leehambley/StrutIsolator_FEM/freecad/StrutIsolator.FCStd

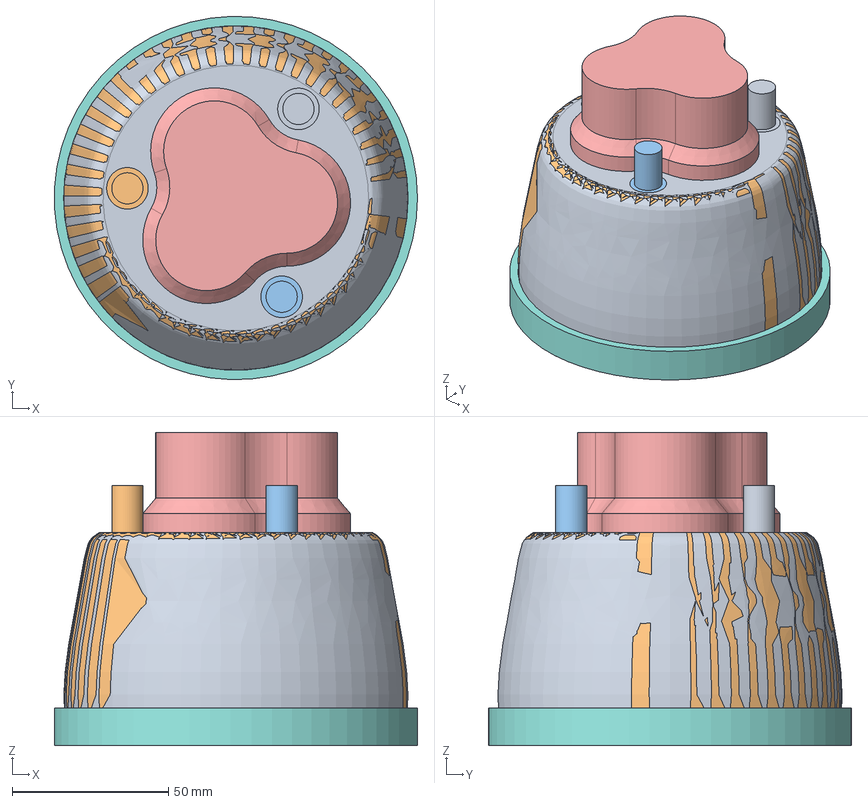
[picture p4: CAD file, 2026-11-12]
freecad/StrutIsolator.FCStd
116.2 x 116.3 x 100.3 mm
TopPlate x 2
CupSide x 2
CupSurface x 2
OuterSolid x 2
HousingPlate x 2
HousingSide x 2
HousingSurface x 2
HousingSolid x 2
Stud1 x 2
Stud2 x 2
Stud3 x 2
Rubber x 2
CastingCore x 2
InnerDisc x 2
PegCollar x 2
PourDam x 2
Body_OuterShell
Body_HousingTop
