leehambley/StrutIsolator_FEM/manufacturing/casting_core_print.stl

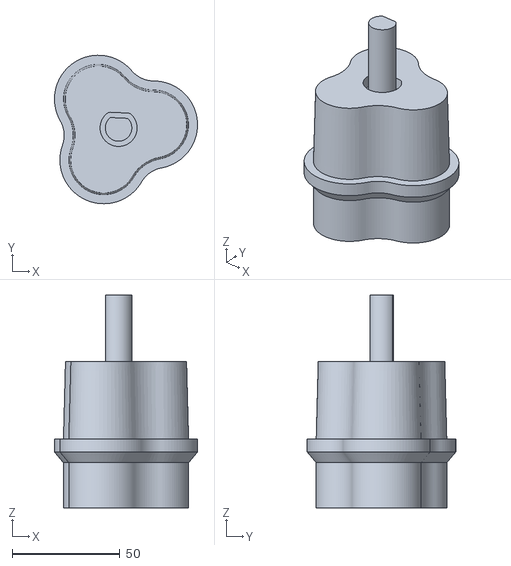
[picture p5: CAD file, 2026-11-12]
manufacturing/casting_core_print.stl
66.5 x 69.0 x 99.0
