leehambley/StrutIsolator_FEM/step/pour_dam.step

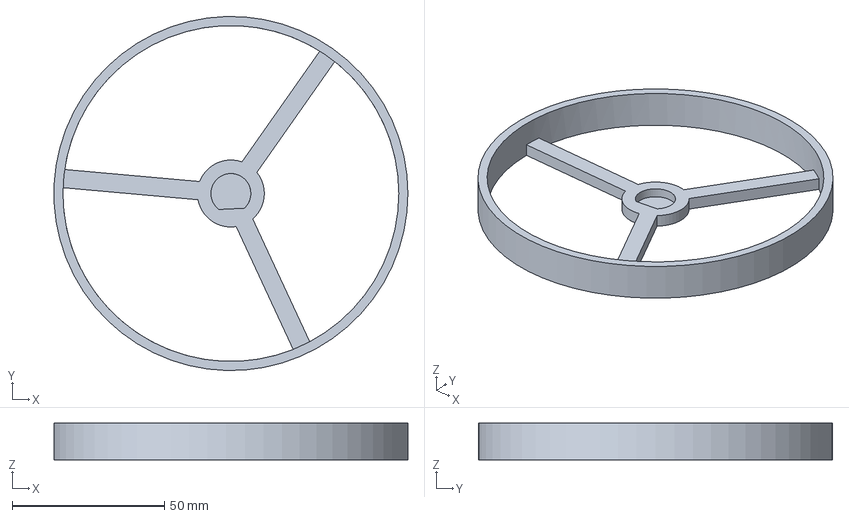
[picture p6: CAD file, 2026-11-12]
step/pour_dam.step
116.2 x 116.3 x 12.0 mm
