leehambley/StrutIsolator_FEM/manufacturing/inner_disc_print.stl

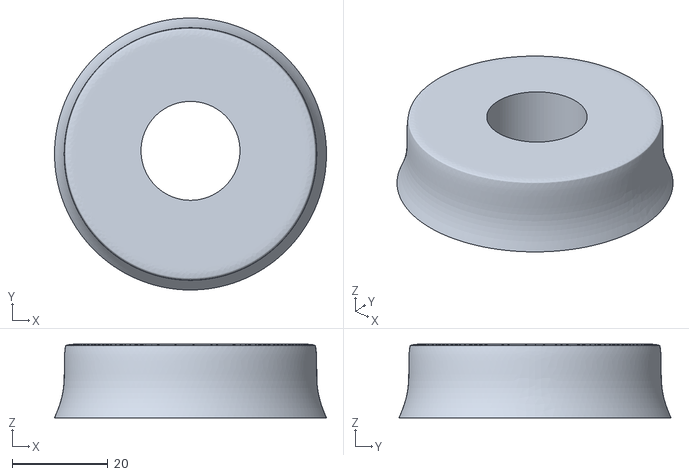
[picture p7: CAD file, 2026-11-12]
manufacturing/inner_disc_print.stl
56.9 x 56.9 x 15.4
