leehambley/StrutIsolator_FEM/step/peg_collar.step

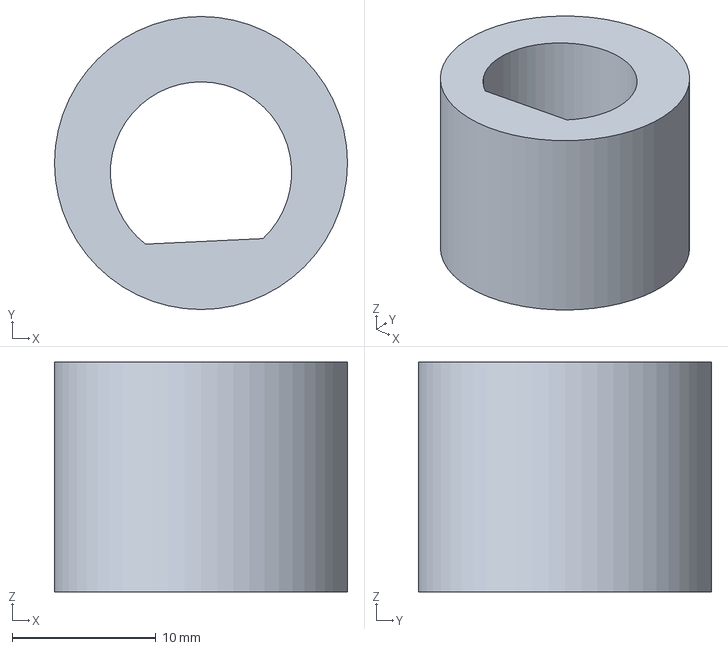
[picture p8: CAD file, 2026-11-12]
step/peg_collar.step
20.4 x 20.4 x 16.0 mm
