leehambley/StrutIsolator_FEM/step/casting_core.step

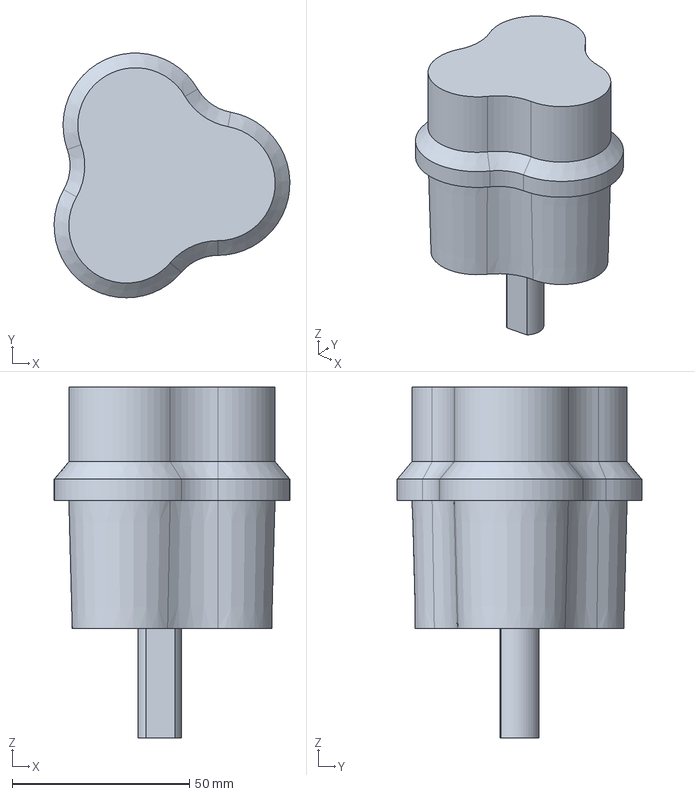
[picture p9: CAD file, 2026-11-09]
step/casting_core.step
66.5 x 69.0 x 99.0 mm
