leehambley/StrutIsolator_FEM/step/rubber_original.step

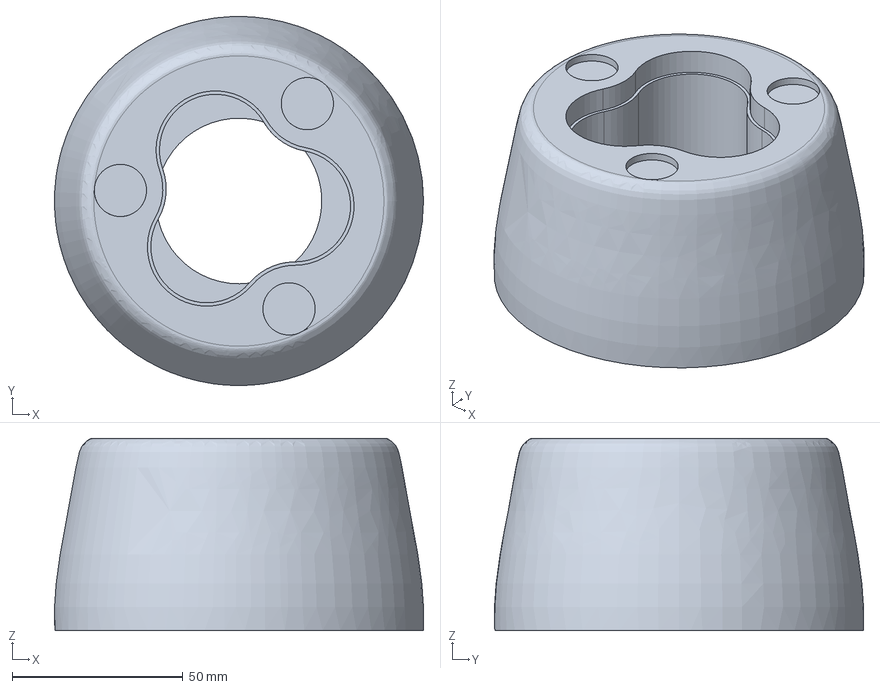
[picture p10: CAD file, 2026-11-09]
step/rubber_original.step
108.1 x 108.1 x 56.3 mm
