leehambley/StrutIsolator_FEM/step/housing_top.step

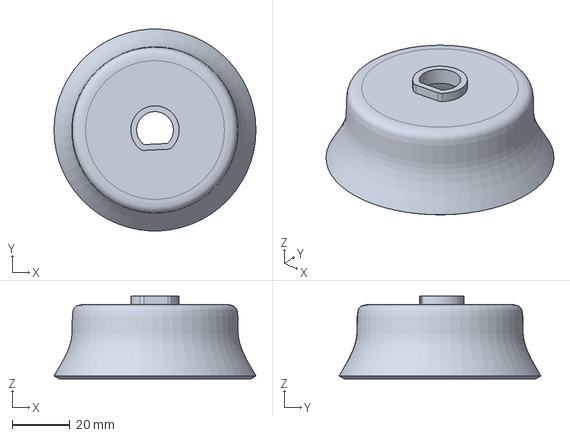
[picture p11: CAD file, 2026-10-30]
step/housing_top.step
69.8 x 69.7 x 28.6 mm
