leehambley/StrutIsolator_FEM/step/outer_shell.step

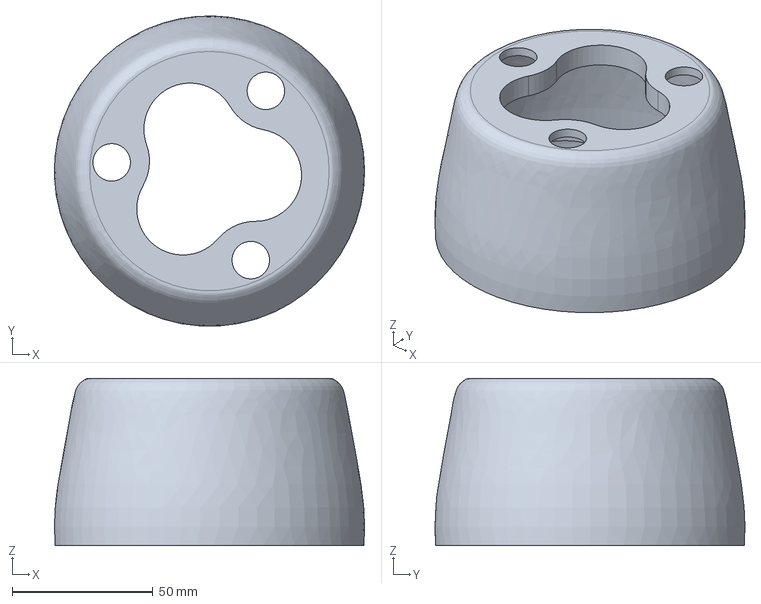
[picture p12: CAD file, 2026-10-30]
step/outer_shell.step
110.2 x 110.1 x 59.3 mm
