leehambley/StrutIsolator_FEM/(list of files, cad)

Other CAD files:
manufacturing/peg_collar_print.stl
step/inner_disc.step
manufacturing/pour_dam_print.stl
print/casting_core.stl
print/inner_disc.stl
print/peg_collar.stl
print/pour_dam.stl
