leehambley/StrutIsolator_FEM/images/section_changes_preview.png

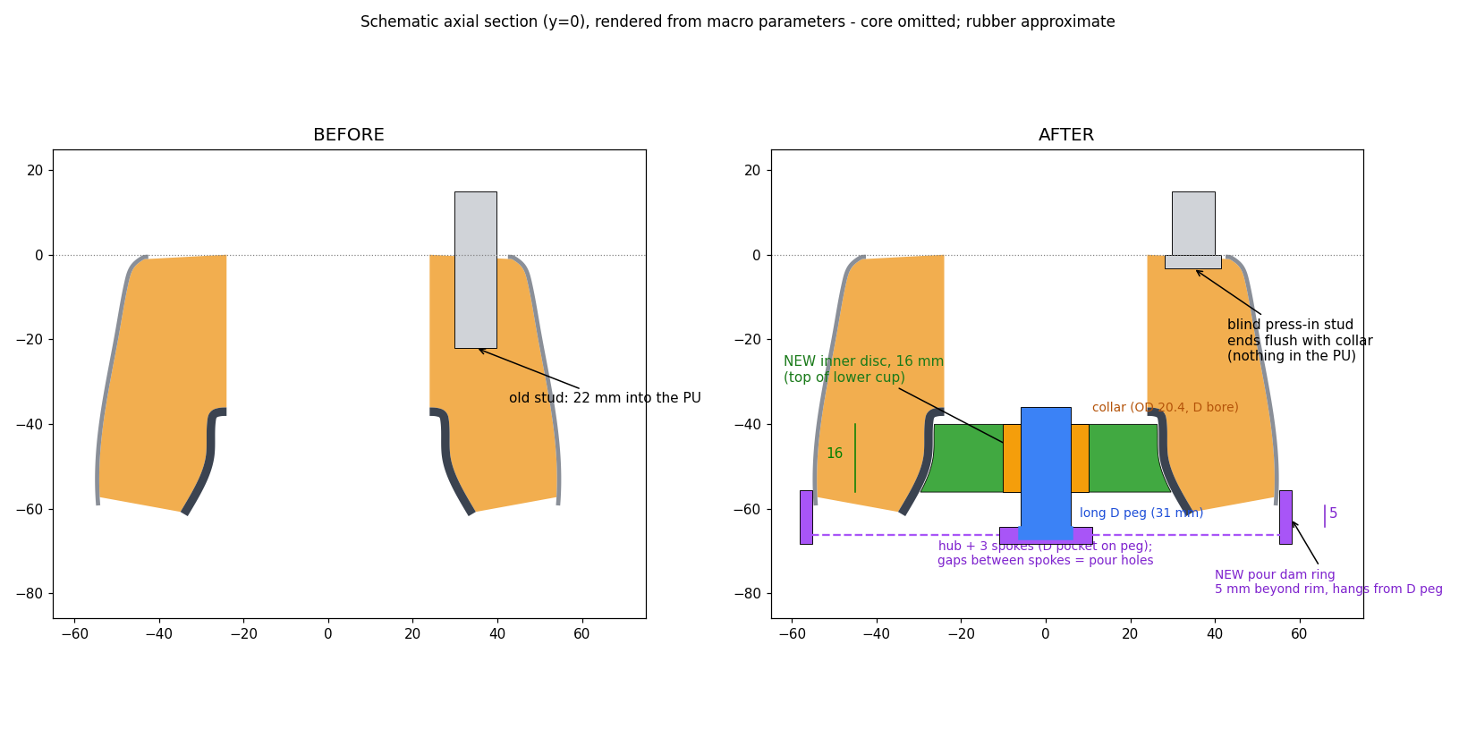
images/section_changes_preview.png
