leehambley/StrutIsolator_FEM/(commit log)

2026-10-30 Add 280Z strut isolator model, casting core, FEM results and macros
    FreeCAD model reverse-engineered from the two scans, STEP/STL exports,
    CalculiX results and animations, and the parametric build macro.
    Claude-Session: https://claude.ai/code/session_014DwErt9jvwaVCvioPG7UC8
    [StrutIsolator.FCStd, casting_core.step, casting_core.stl, casting_core_print_orientation.stl, housing_top.step, outer_shell.step, rubber_original.step]
2026-11-09 Blind press-in studs, 12 mm inner disc, peg collar and longer D peg
    Studs now end flush with the bolt-hole collar instead of embedding 22 mm.
    Add parametric InnerDisc (DISC_H) and PegCollar (20 mm hole) parts; D peg
    length follows the disc height. Add schematic section preview.
2026-11-09 Pour dam with D-peg hub, inner disc, peg collar; rebuilt outputs
    Macro verified in FreeCAD 1.1 (all solids valid, no part overlaps, positive
    clearances). PourDam is a ring over the shell rim with a spoked hub that
    seats on the now ~31 mm D peg; spoke gaps are the pour holes. Regenerated
    STEP/STL/FCStd. casting_core_print_orientation.stl is stale.
    [StrutIsolator.FCStd, casting_core.step, casting_core.stl, inner_disc.step, inner_disc.stl, peg_collar.step, peg_collar.stl, pour_dam.step]
2026-11-12 refine pouring molds
    [StrutIsolator.FCStd, casting_core_print.stl, casting_core_print_orientation.stl, inner_disc.step, inner_disc.stl, inner_disc_print.stl, peg_collar.step, peg_collar.stl]
